eescirocco85/vca/README.md

# vca
Voltage Controlled Amp with loudness for our Record Player
