eescirocco85/vca/vca.kicad_pcb

## KiCad design vca.kicad_pcb (2026-04-27)

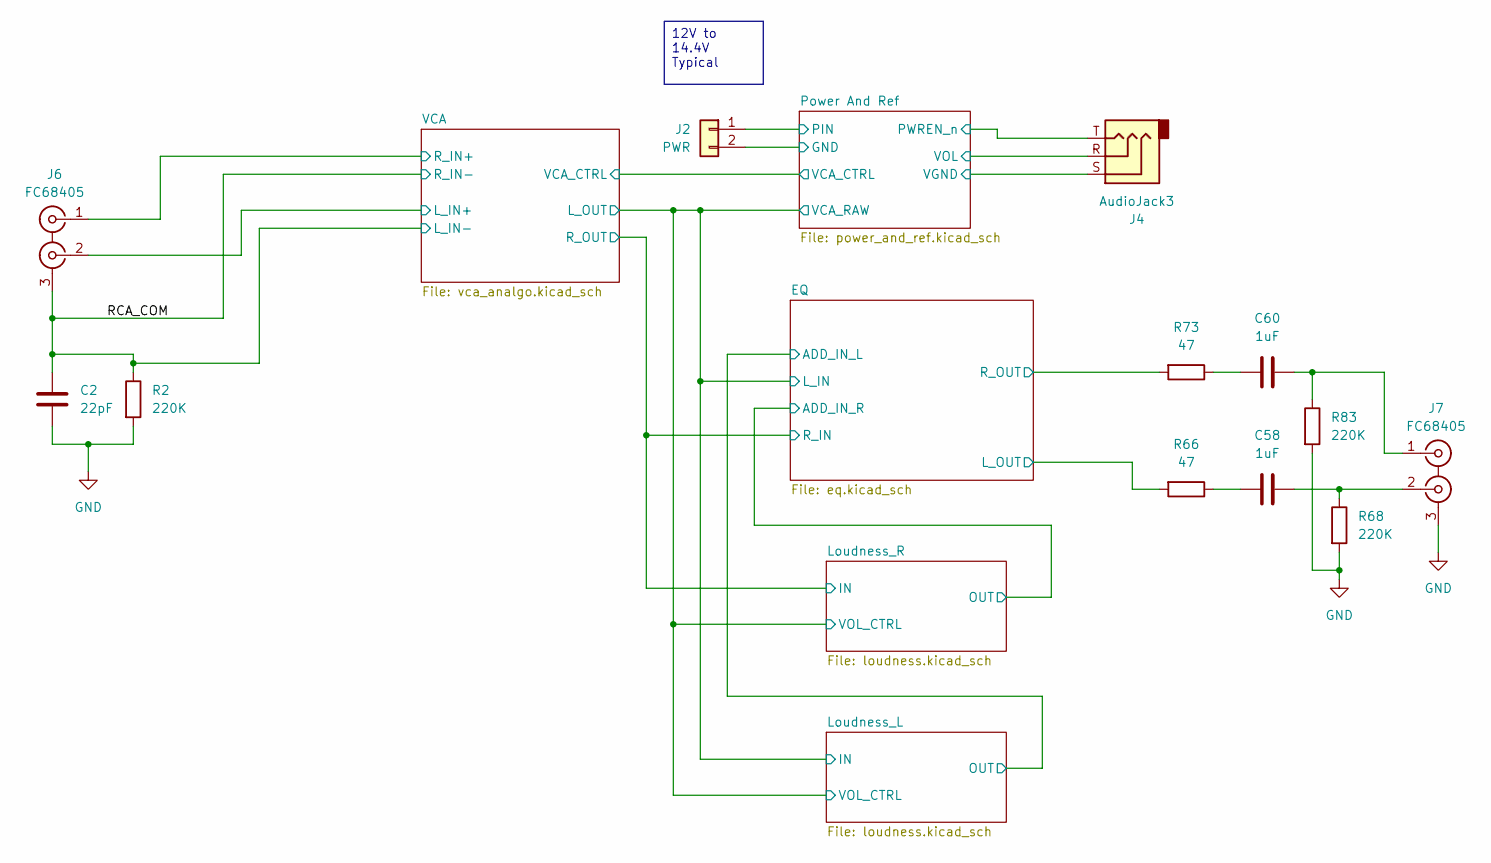
[picture p5: schematic vca.kicad_sch]

Parts:
C2: 22pF; C_0805_2012Metric_Pad1.18x1.45mm_HandSolder
C58, C60: 1uF; C_1210_3225Metric_Pad1.33x2.70mm_HandSolder
J2: PWR; BarrelJack_CUI_PJ-063AH_Horizontal_CircularHoles
J4: AudioJack3; Jack_3.5mm_CUI_SJ1-3533NG_Horizontal_CircularHoles
J6, J7: FC68405; DualVertRca
R2, R68, R83: 220K; R_1206_3216Metric_Pad1.30x1.75mm_HandSolder
R66, R73: 47; R_1206_3216Metric_Pad1.30x1.75mm_HandSolder

Connections:
/EQ/L_OUT: R66.2; also elsewhere on the board
/EQ/R_OUT: R73.2; also elsewhere on the board
/Power And Ref/PIN: J2.1; also elsewhere on the board
/Power And Ref/PWREN_n: J4.T; also elsewhere on the board
/Power And Ref/VGND: J4.S; also elsewhere on the board
/Power And Ref/VOL: J4.R; also elsewhere on the board
/RCA_COM: C2.1, J6.3 (EXT), R2.1; also elsewhere on the board
/VCA/L_IN+: J6.2 (IN2); also elsewhere on the board
/VCA/R_IN+: J6.1 (IN1); also elsewhere on the board
GND: C2.2, J2.2, J7.3 (EXT), R2.2, R68.2, R83.2; also elsewhere on the board
unnamed: C58.1, R66.1
unnamed: C60.1, R73.1
unnamed: C60.2, J7.1 (IN1), R83.1
unnamed: C58.2, J7.2 (IN2), R68.1

Notes on the sheet:
12V to 14.4V Typical

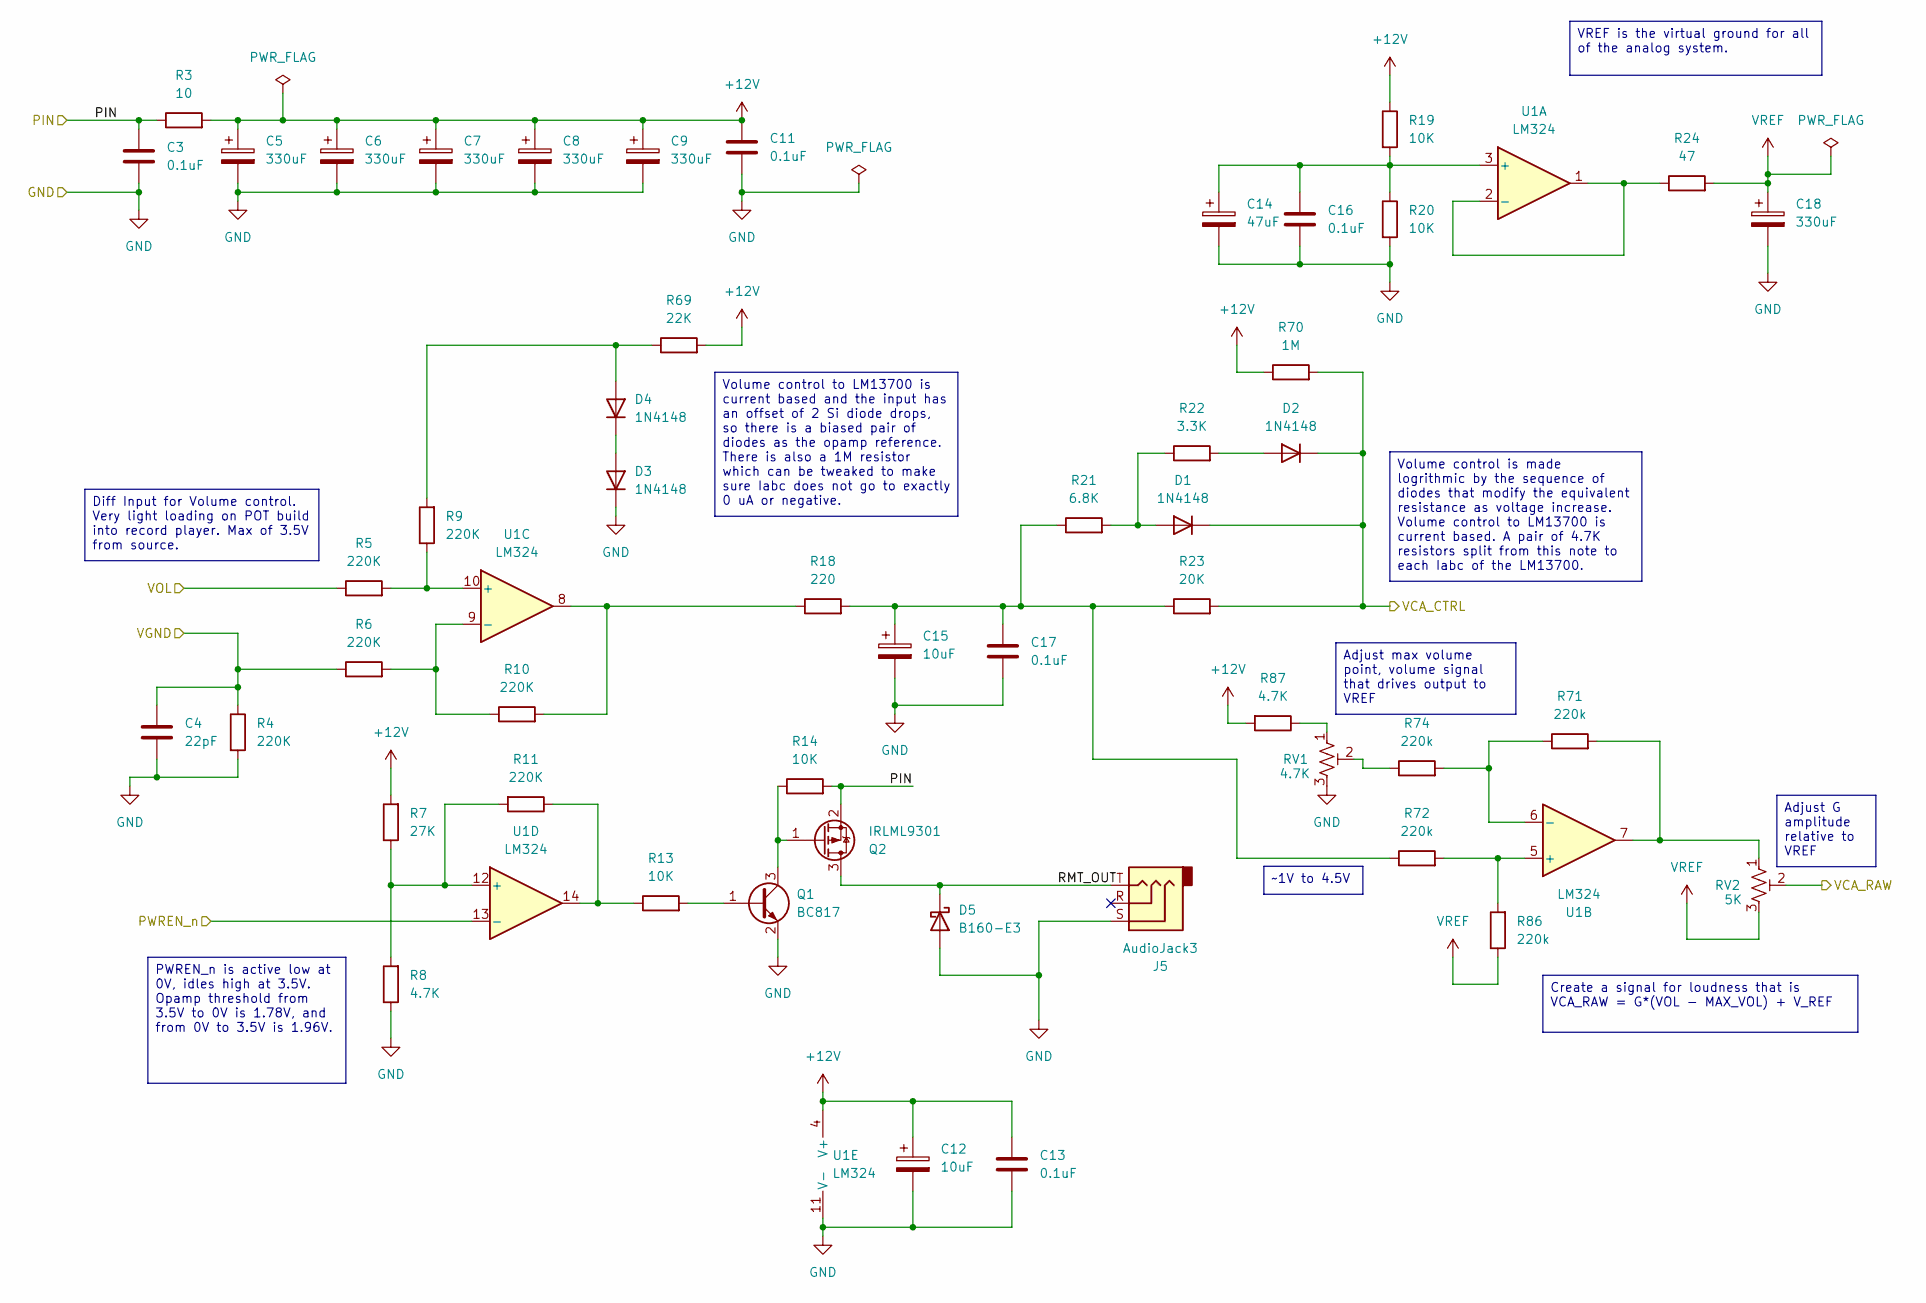
[picture p6: schematic power_and_ref.kicad_sch]

Parts:
C3, C11, C13, C16, C17: 0.1uF; C_0805_2012Metric_Pad1.18x1.45mm_HandSolder
C4: 22pF; C_0805_2012Metric_Pad1.18x1.45mm_HandSolder
C5, C6, C7, C8, C9, C18: 330uF; C_Radial_D10.0mm_H20.0mm_P5.00mm
C12, C15: 10uF; C_Radial_D5.0mm_H11.0mm_P2.00mm
C14: 47uF; C_Radial_D5.0mm_H11.0mm_P2.00mm
D1, D2, D3, D4: 1N4148; D_DO-35_SOD27_P7.62mm_Horizontal
D5: B160-E3; D_SMA
J5: AudioJack3; Jack_3.5mm_CUI_SJ1-3533NG_Horizontal_CircularHoles
Q1: BC817; SOT-23
Q2: IRLML9301; SOT-23
R3: 10; R_1206_3216Metric_Pad1.30x1.75mm_HandSolder
R4, R5, R6, R9, R10, R11: 220K; R_1206_3216Metric_Pad1.30x1.75mm_HandSolder
R7: 27K; R_1206_3216Metric_Pad1.30x1.75mm_HandSolder
R8, R87: 4.7K; R_1206_3216Metric_Pad1.30x1.75mm_HandSolder
R13, R14, R19, R20: 10K; R_1206_3216Metric_Pad1.30x1.75mm_HandSolder
R18: 220; R_1206_3216Metric_Pad1.30x1.75mm_HandSolder
R21: 6.8K; R_1206_3216Metric_Pad1.30x1.75mm_HandSolder
R22: 3.3K; R_1206_3216Metric_Pad1.30x1.75mm_HandSolder
R23: 20K; R_1206_3216Metric_Pad1.30x1.75mm_HandSolder
R24: 47; R_1206_3216Metric_Pad1.30x1.75mm_HandSolder
R69: 22K; R_1206_3216Metric_Pad1.30x1.75mm_HandSolder
R70: 1M; R_1206_3216Metric_Pad1.30x1.75mm_HandSolder
R71, R72, R74, R86: 220k; R_1206_3216Metric_Pad1.30x1.75mm_HandSolder
RV1: 4.7K
RV2: 5K
U1: LM324; SOIC-14_3.9x8.7mm_P1.27mm

Connections:
+12V: C5.1, C6.1, C7.1, C8.1, C9.1, C11.1, C12.1, C13.1, R3.2, R7.2, R19.1, R69.2, R70.1, R87.2, U1.4 (V+); also elsewhere on the board
/Power And Ref/PIN: C3.1, Q2.2 (S), R3.1, R14.2; also elsewhere on the board
/Power And Ref/PWREN_n: U1.13 (-); also elsewhere on the board
/Power And Ref/RMT_OUT: D5.1 (K), J5.T, Q2.3 (D)
/Power And Ref/VCA_CTRL: D1.1 (K), D2.1 (K), R23.2, R70.2; also elsewhere on the board
/Power And Ref/VGND: C4.1, R4.1, R6.1; also elsewhere on the board
/Power And Ref/VOL: R5.1; also elsewhere on the board
GND: C3.2, C4.2, C5.2, C6.2, C7.2, C8.2, C9.2, C11.2, C12.2, C13.2, C14.2, C15.2, C16.2, C17.2, C18.2, D3.1 (K), D5.2 (A), J5.S, Q1.2 (E), R4.2, R8.1, R20.2, RV1.3, U1.11 (V-); also elsewhere on the board
unnamed: C15.1, C17.1, R18.2, R21.1, R23.1, R72.1
unnamed: D1.2 (A), R21.2, R22.1
unnamed: D2.2 (A), R22.2
unnamed: D3.2 (A), D4.1 (K)
unnamed: D4.2 (A), R9.2, R69.1
unnamed: Q1.1 (B), R13.2
unnamed: Q1.3 (C), Q2.1 (G), R14.1
unnamed: R10.2, R18.1, U1.8
unnamed: R11.1, R13.1, U1.14
unnamed: R71.2, RV2.1, U1.7
unnamed: R74.1, RV1.2
unnamed: R87.1, RV1.1
unnamed: C14.1, C16.1, R19.2, R20.1, U1.3 (+)
unnamed: R24.1, U1.1, U1.2 (-)
unnamed: R72.2, R86.2, U1.5 (+)
unnamed: R71.1, R74.2, U1.6 (-)
unnamed: R5.2, R9.1, U1.10 (+)
unnamed: R6.2, R10.1, U1.9 (-)
unnamed: R7.1, R8.2, R11.2, U1.12 (+)
VREF: C18.1, R24.2, R86.1, RV2.3; also elsewhere on the board

Notes on the sheet:
~1V to 4.5V
PWREN_n is active low at 0V, idles high at 3.5V. Opamp threshold from 3.5V to 0V is 1.78V, and from 0V to 3.5V is 1.96V.
Diff Input for Volume control. Very light loading on POT build into record player. Max of 3.5V from source.
Volume control is made logrithmic by the sequence of diodes that modify the equivalent resistance as voltage increase. Volume control to LM13700 is current based. A pair of 4.7K resistors split from this note to each Iabc of the LM13700.
Volume control to LM13700 is current based and the input has an offset of 2 Si diode drops, so there is a biased pair of diodes as the opamp reference. There is also a 1M resistor which can be tweaked to make sure Iabc does not go to exactly 0 uA or negative.
Adjust max volume point, volume signal that drives output to VREF
Adjust G amplitude relative to VREF
VREF is the virtual ground for all of the analog system.
Create a signal for loudness that is VCA_RAW = G*(VOL - MAX_VOL) + V_REF

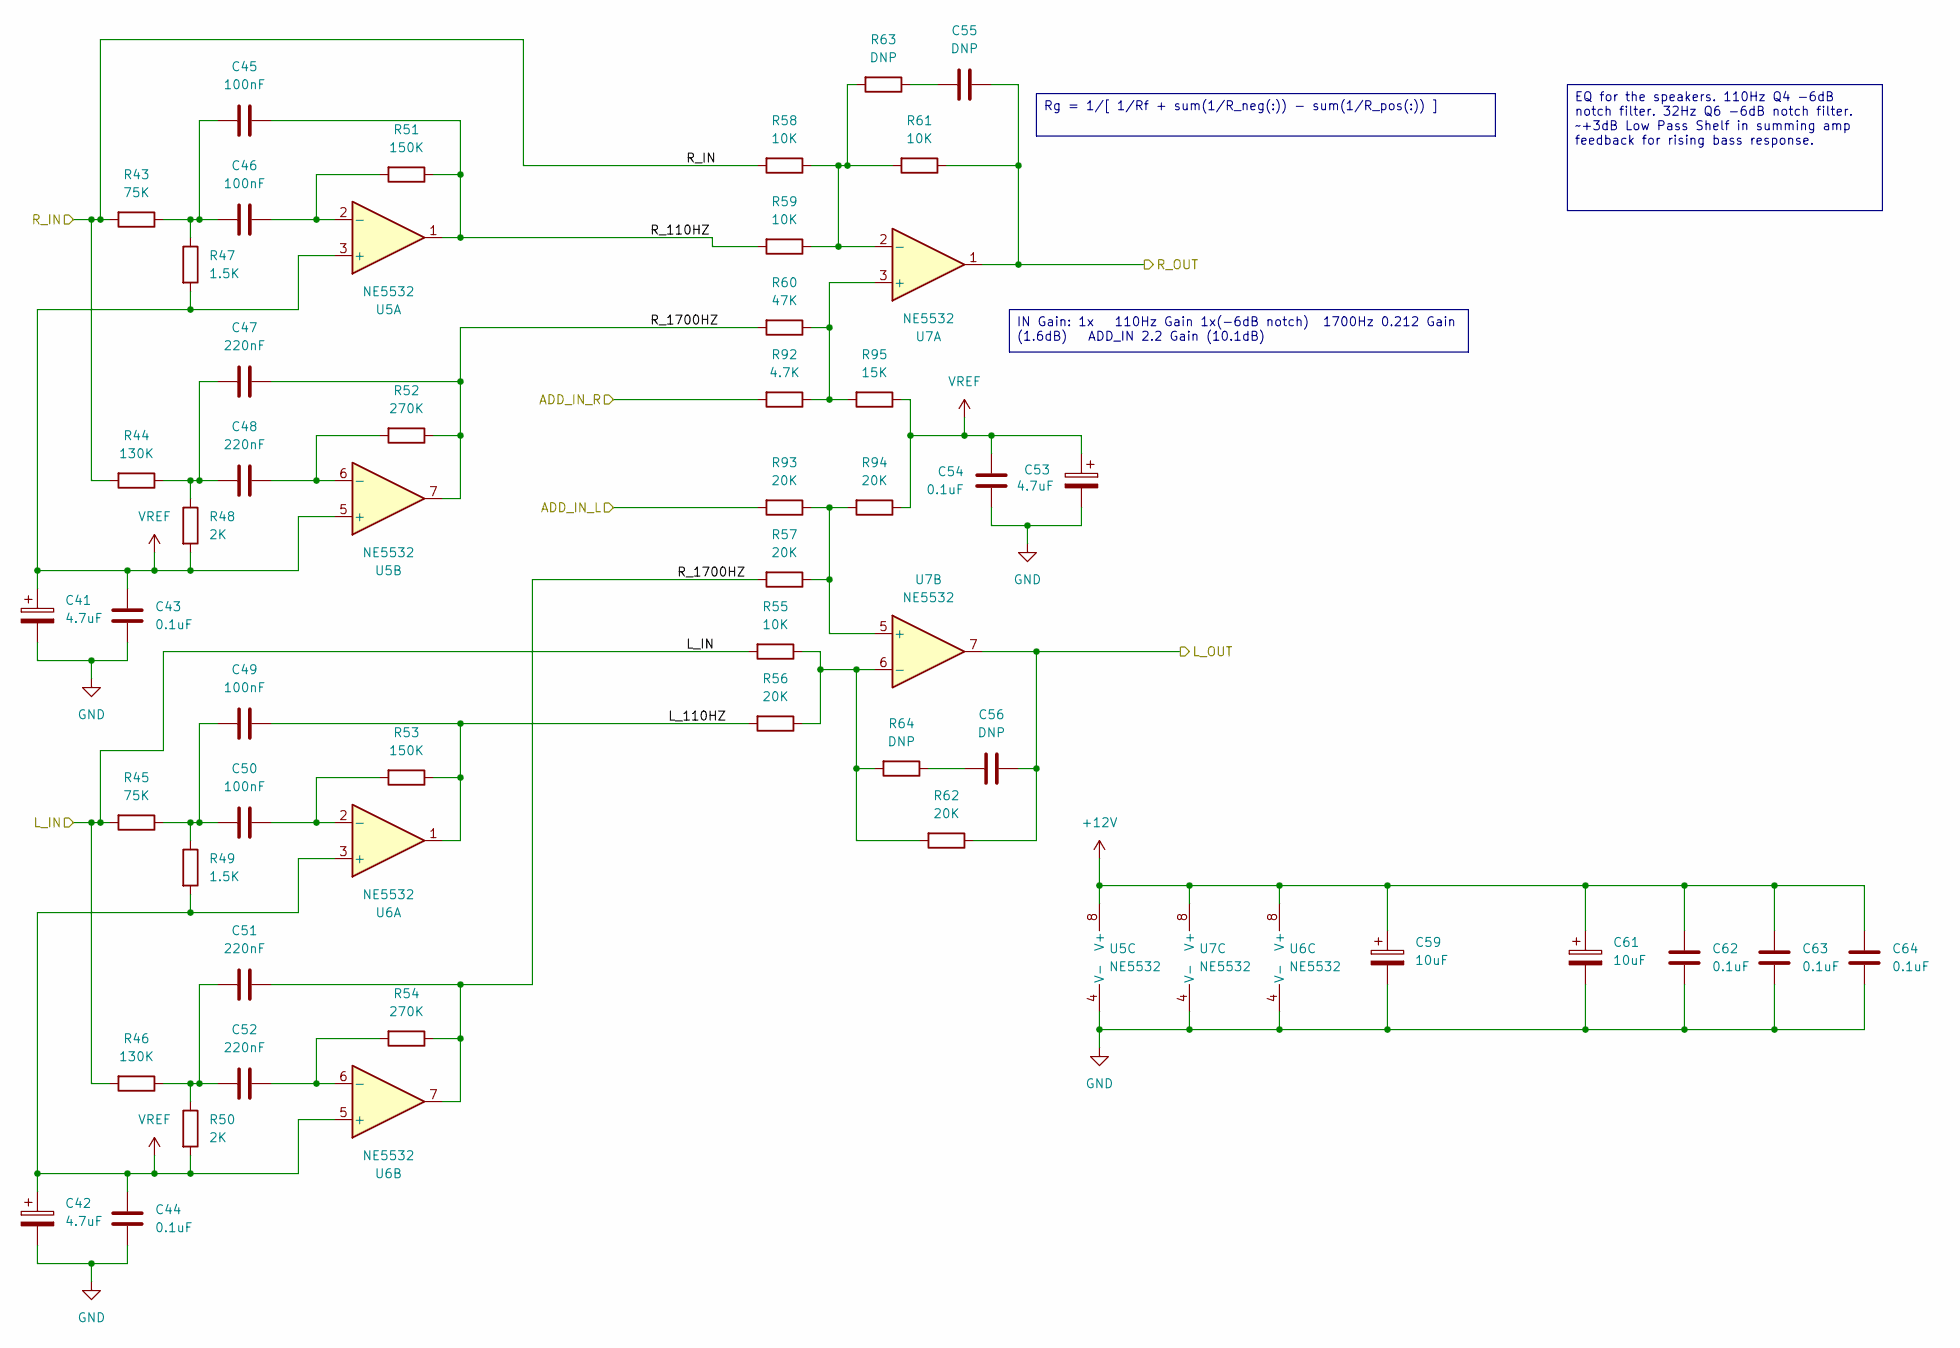
[picture p7: schematic eq.kicad_sch]

Parts:
C41, C42, C53: 4.7uF; C_Radial_D5.0mm_H7.0mm_P2.00mm
C43, C44, C54, C62, C63, C64: 0.1uF; C_0805_2012Metric_Pad1.18x1.45mm_HandSolder
C45, C46, C49, C50: 100nF; C_1812_4532Metric_Pad1.57x3.40mm_HandSolder
C47, C48, C51, C52: 220nF; C_2220_5750Metric_Pad1.97x5.40mm_HandSolder
C55, C56: DNP; C_1812_4532Metric_Pad1.57x3.40mm_HandSolder
C59, C61: 10uF; C_Radial_D5.0mm_H11.0mm_P2.00mm
R43, R45: 75K; R_1206_3216Metric_Pad1.30x1.75mm_HandSolder
R44, R46: 130K; R_1206_3216Metric_Pad1.30x1.75mm_HandSolder
R47, R49: 1.5K; R_1206_3216Metric_Pad1.30x1.75mm_HandSolder
R48, R50: 2K; R_1206_3216Metric_Pad1.30x1.75mm_HandSolder
R51, R53: 150K; R_1206_3216Metric_Pad1.30x1.75mm_HandSolder
R52, R54: 270K; R_1206_3216Metric_Pad1.30x1.75mm_HandSolder
R55, R58, R59, R61: 10K; R_1206_3216Metric_Pad1.30x1.75mm_HandSolder
R56, R57, R62, R93, R94: 20K; R_1206_3216Metric_Pad1.30x1.75mm_HandSolder
R60: 47K; R_1206_3216Metric_Pad1.30x1.75mm_HandSolder
R63, R64: DNP; R_1206_3216Metric_Pad1.30x1.75mm_HandSolder
R92: 4.7K; R_1206_3216Metric_Pad1.30x1.75mm_HandSolder
R95: 15K; R_1206_3216Metric_Pad1.30x1.75mm_HandSolder
U5, U6, U7: NE5532; SOIC-8_3.9x4.9mm_P1.27mm

Connections:
+12V: C59.1, C61.1, C62.1, C63.1, C64.1, U5.8 (V+), U6.8 (V+), U7.8 (V+); also elsewhere on the board
/EQ/ADD_IN_L: R93.2; also elsewhere on the board
/EQ/ADD_IN_R: R92.2; also elsewhere on the board
/EQ/L_110HZ: C49.2, R53.1, R56.2, U6.1
/EQ/L_IN: R45.2, R46.2, R55.2; also elsewhere on the board
/EQ/L_OUT: C56.2, R62.1, U7.7; also elsewhere on the board
/EQ/R_110HZ: C45.2, R51.1, R59.2, U5.1
/EQ/R_1700HZ: C47.2, C51.2, R52.1, R54.1, R57.2, R60.2, U5.7, U6.7
/EQ/R_IN: R43.2, R44.2, R58.2; also elsewhere on the board
/EQ/R_OUT: C55.2, R61.1, U7.1; also elsewhere on the board
GND: C41.2, C42.2, C43.2, C44.2, C53.2, C54.2, C59.2, C61.2, C62.2, C63.2, C64.2, U5.4 (V-), U6.4 (V-), U7.4 (V-); also elsewhere on the board
unnamed: C45.1, C46.1, R43.1, R47.1
unnamed: C47.1, C48.1, R44.1, R48.1
unnamed: C49.1, C50.1, R45.1, R49.1
unnamed: C51.1, C52.1, R46.1, R50.1
unnamed: C55.1, R63.1
unnamed: C56.1, R64.1
unnamed: C46.2, R51.2, U5.2 (-)
unnamed: C48.2, R52.2, U5.6 (-)
unnamed: C50.2, R53.2, U6.2 (-)
unnamed: C52.2, R54.2, U6.6 (-)
unnamed: R60.1, R92.1, R95.2, U7.3 (+)
unnamed: R58.1, R59.1, R61.2, R63.2, U7.2 (-)
unnamed: R57.1, R93.1, R94.2, U7.5 (+)
unnamed: R55.1, R56.1, R62.2, R64.2, U7.6 (-)
VREF: C41.1, C42.1, C43.1, C44.1, C53.1, C54.1, R47.2, R48.2, R49.2, R50.2, R94.1, R95.1, U5.3 (+), U5.5 (+), U6.3 (+), U6.5 (+); also elsewhere on the board

Notes on the sheet:
EQ for the speakers. 110Hz Q4 -6dB notch filter. 32Hz Q6 -6dB notch filter. ~+3dB Low Pass Shelf in summing amp feedback for rising bass response.
Rg = 1/[ 1/Rf + sum(1/R_neg(:)) - sum(1/R_pos(:)) ]
IN Gain: 1x 110Hz Gain 1x(-6dB notch) 1700Hz 0.212 Gain (1.6dB) ADD_IN 2.2 Gain (10.1dB)

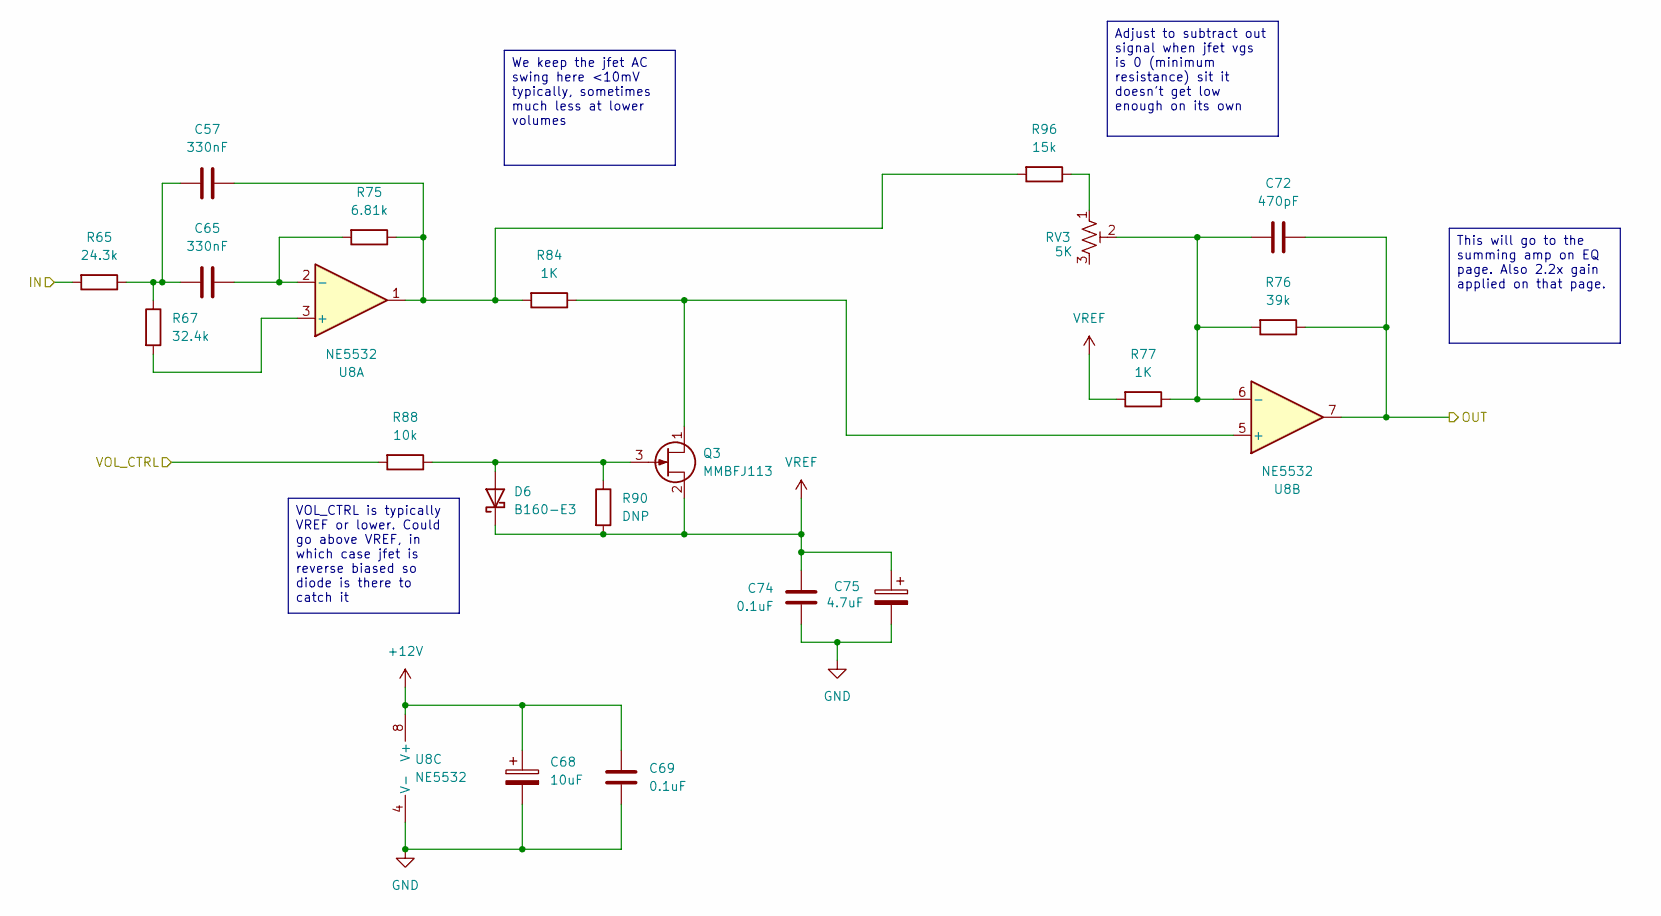
[picture p8: schematic loudness.kicad_sch]

Parts:
C57, C65: 330nF; C_2220_5750Metric_Pad1.97x5.40mm_HandSolder
C68: 10uF; C_Radial_D5.0mm_H11.0mm_P2.00mm
C69, C74: 0.1uF; C_0805_2012Metric_Pad1.18x1.45mm_HandSolder
C72: 470pF; C_0805_2012Metric_Pad1.18x1.45mm_HandSolder
C75: 4.7uF; C_Radial_D5.0mm_H7.0mm_P2.00mm
D6: B160-E3; D_SMA
Q3: MMBFJ113; SOT-23
R65: 24.3k; R_1206_3216Metric_Pad1.30x1.75mm_HandSolder
R67: 32.4k; R_1206_3216Metric_Pad1.30x1.75mm_HandSolder
R75: 6.81k; R_1206_3216Metric_Pad1.30x1.75mm_HandSolder
R76: 39k; R_1206_3216Metric_Pad1.30x1.75mm_HandSolder
R77, R84: 1K; R_1206_3216Metric_Pad1.30x1.75mm_HandSolder
R88: 10k; R_1206_3216Metric_Pad1.30x1.75mm_HandSolder
R90: DNP; R_1206_3216Metric_Pad1.30x1.75mm_HandSolder
R96: 15k; R_1206_3216Metric_Pad1.30x1.75mm_HandSolder
RV3: 5K
U8: NE5532

Connections:
+12V: C68.1, C69.1, U8.8 (V+); also elsewhere on the board
/EQ/ADD_IN_R: C72.2, R76.1; also elsewhere on the board
/EQ/L_IN: R88.2; also elsewhere on the board
/EQ/R_IN: R65.2; also elsewhere on the board
GND: C68.2, C69.2, C74.2, C75.2, U8.4 (V-); also elsewhere on the board
unnamed: C57.1, C65.1, R65.1, R67.1
unnamed: C57.2, R75.1, R84.2
unnamed: D6.2 (A), Q3.3 (G), R88.1, R90.1
unnamed: Q3.1 (D), R84.1
unnamed: R96.1, RV3.1
unnamed: C65.2, R75.2
unnamed: C72.1, R76.2, R77.1
VREF: C74.1, C75.1, D6.1 (K), Q3.2 (S), R77.2, R90.2; also elsewhere on the board

Parts of its further copies:
C70: 10uF; C_Radial_D5.0mm_H11.0mm_P2.00mm
C71, C76: 0.1uF; C_0805_2012Metric_Pad1.18x1.45mm_HandSolder
C73: 470pF; C_0805_2012Metric_Pad1.18x1.45mm_HandSolder
C77: 4.7uF; C_Radial_D5.0mm_H7.0mm_P2.00mm
D7: B160-E3; D_SMA
Q4: MMBFJ113; SOT-23
R81, R85: 1K; R_1206_3216Metric_Pad1.30x1.75mm_HandSolder
R89: 10k; R_1206_3216Metric_Pad1.30x1.75mm_HandSolder
R91: DNP; R_1206_3216Metric_Pad1.30x1.75mm_HandSolder

Connections of its further copies:
+12V: C70.1, C71.1; also elsewhere on the board
/EQ/ADD_IN_L: C73.2; also elsewhere on the board
/EQ/L_IN: R89.2; also elsewhere on the board
GND: C70.2, C71.2, C76.2, C77.2; also elsewhere on the board
unnamed 38: R85.2; also elsewhere on the board
unnamed: D7.2 (A), Q4.3 (G), R89.1, R91.1
unnamed: Q4.1 (D), R85.1
unnamed 87: C73.1, R81.1; also elsewhere on the board
VREF: C76.1, C77.1, D7.1 (K), Q4.2 (S), R81.2, R91.2; also elsewhere on the board

Notes on the sheet:
We keep the jfet AC swing here <10mV typically, sometimes much less at lower volumes
Adjust to subtract out signal when jfet vgs is 0 (minimum resistance) sit it doesn't get low enough on its own
This will go to the summing amp on EQ page. Also 2.2x gain applied on that page.
VOL_CTRL is typically VREF or lower. Could go above VREF, in which case jfet is reverse biased so diode is there to catch it

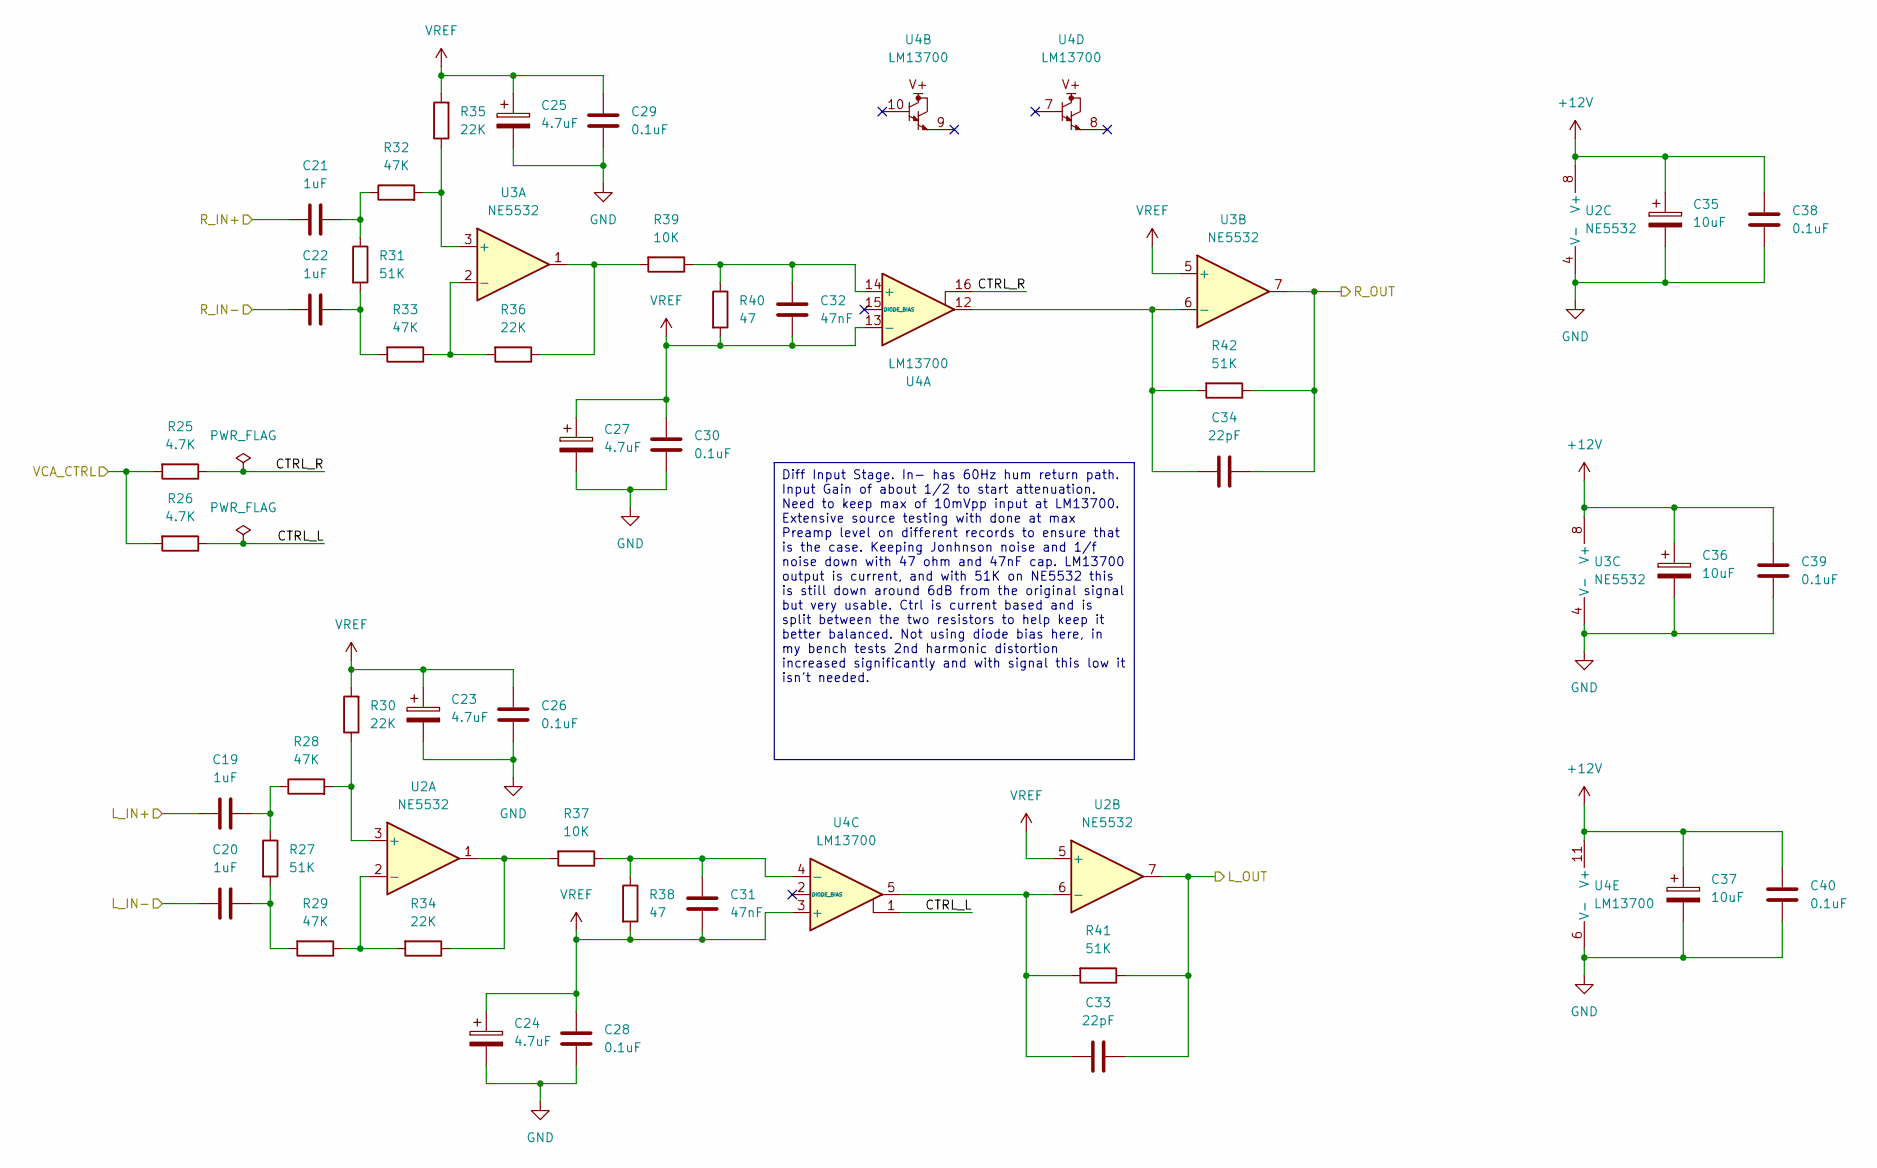
[picture p9: schematic vca_analgo.kicad_sch]

Parts:
C19, C20, C21, C22: 1uF; C_1210_3225Metric_Pad1.33x2.70mm_HandSolder
C23, C24, C25, C27: 4.7uF; C_Radial_D5.0mm_H7.0mm_P2.00mm
C26, C28, C29, C30, C38, C39, C40: 0.1uF; C_0805_2012Metric_Pad1.18x1.45mm_HandSolder
C31, C32: 47nF; C_1812_4532Metric_Pad1.57x3.40mm_HandSolder
C33, C34: 22pF; C_0805_2012Metric_Pad1.18x1.45mm_HandSolder
C35, C36, C37: 10uF; C_Radial_D5.0mm_H11.0mm_P2.00mm
R25, R26: 4.7K; R_1206_3216Metric_Pad1.30x1.75mm_HandSolder
R27, R31, R41, R42: 51K; R_1206_3216Metric_Pad1.30x1.75mm_HandSolder
R28, R29, R32, R33: 47K; R_1206_3216Metric_Pad1.30x1.75mm_HandSolder
R30, R34, R35, R36: 22K; R_1206_3216Metric_Pad1.30x1.75mm_HandSolder
R37, R39: 10K; R_1206_3216Metric_Pad1.30x1.75mm_HandSolder
R38, R40: 47; R_1206_3216Metric_Pad1.30x1.75mm_HandSolder
U2, U3: NE5532; SOIC-8_3.9x4.9mm_P1.27mm
U4: LM13700; SOIC-16_3.9x9.9mm_P1.27mm

Connections:
+12V: C35.1, C36.1, C37.1, C38.1, C39.1, C40.1, U2.8 (V+), U3.8 (V+), U4.11 (V+); also elsewhere on the board
/EQ/L_IN: C33.2, R41.1, U2.7; also elsewhere on the board
/EQ/R_IN: C34.2, R42.1, U3.7; also elsewhere on the board
/Power And Ref/VCA_CTRL: R25.2, R26.2; also elsewhere on the board
/RCA_COM: C20.1, C22.1; also elsewhere on the board
/VCA/CTRL_L: R26.1, U4.1
/VCA/CTRL_R: R25.1, U4.16
/VCA/L_IN+: C19.1; also elsewhere on the board
/VCA/R_IN+: C21.1; also elsewhere on the board
GND: C23.2, C24.2, C25.2, C26.2, C27.2, C28.2, C29.2, C30.2, C35.2, C36.2, C37.2, C38.2, C39.2, C40.2, U2.4 (V-), U3.4 (V-), U4.6 (V-); also elsewhere on the board
unnamed: C19.2, R27.1, R28.1
unnamed: C20.2, R27.2, R29.2
unnamed: C21.2, R31.1, R32.1
unnamed: C22.2, R31.2, R33.2
unnamed: R34.1, R37.2, U2.1
unnamed: R36.1, R39.2, U3.1
unnamed: R28.2, R30.1, U2.3 (+)
unnamed: R29.1, R34.2, U2.2 (-)
unnamed: C33.1, R41.2, U2.6 (-), U4.5
unnamed: R32.2, R35.1, U3.3 (+)
unnamed: R33.1, R36.2, U3.2 (-)
unnamed: C34.1, R42.2, U3.6 (-), U4.12
unnamed: C32.2, R39.1, R40.1, U4.14 (+)
unnamed: C31.2, R37.1, R38.1, U4.4 (-)
VREF: C23.1, C24.1, C25.1, C26.1, C27.1, C28.1, C29.1, C30.1, C31.1, C32.1, R30.2, R35.2, R38.2, R40.2, U2.5 (+), U3.5 (+), U4.3 (+), U4.13 (-); also elsewhere on the board

Notes on the sheet:
Diff Input Stage. In- has 60Hz hum return path. Input Gain of about 1/2 to start attenuation. Need to keep max of 10mVpp input at LM13700. Extensive source testing with done at max Preamp level on different records to ensure that is the case. Keeping Jonhnson noise and 1/f noise down with 47 ohm an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

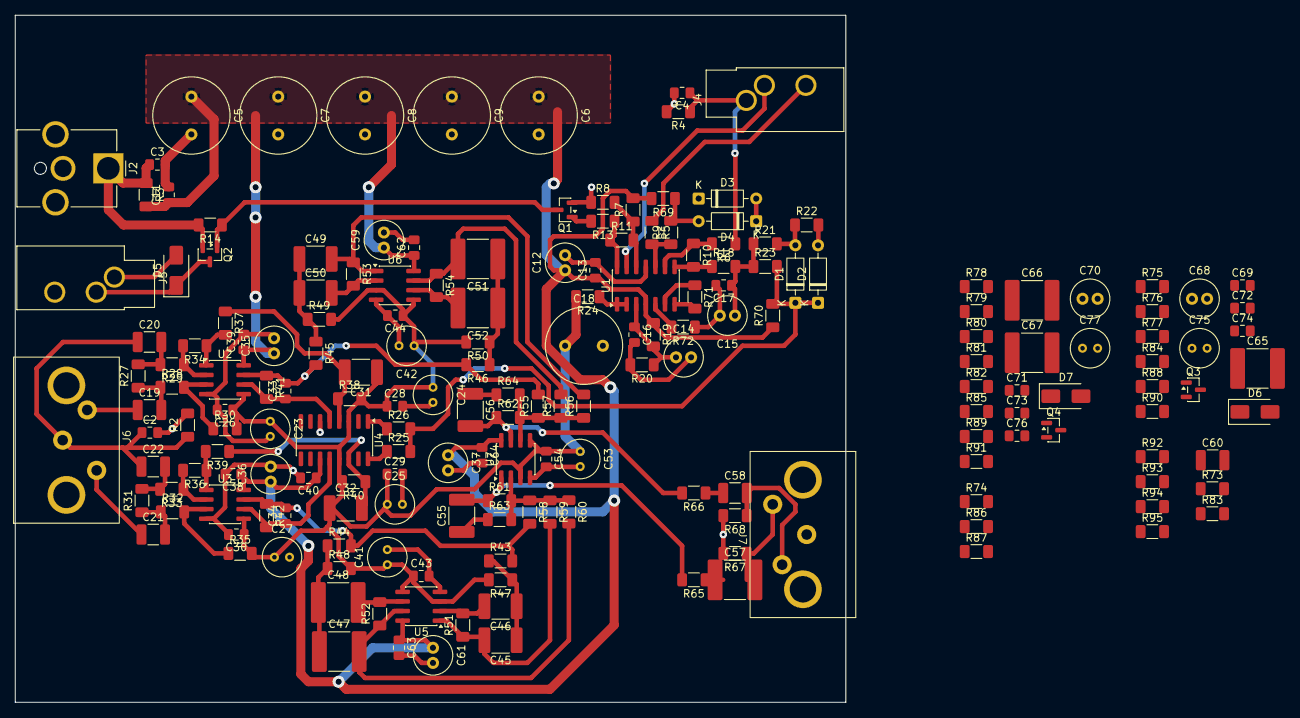
[picture p10: board vca.kicad_pcb from above]

Board: 2 copper layers, 110.0 x 91.0 mm, 188 parts (0 on the bottom side), 84 nets.

Other parts of the board:
C66, C67: 220nF; C_2220_5750Metric_Pad1.97x5.40mm_HandSolder
R78: 75K; R_1206_3216Metric_Pad1.30x1.75mm_HandSolder
R79: 1.5K; R_1206_3216Metric_Pad1.30x1.75mm_HandSolder
R80: 150K; R_1206_3216Metric_Pad1.30x1.75mm_HandSolder
R82: 47K; R_1206_3216Metric_Pad1.30x1.75mm_HandSolder

Their connections:
/EQ/ADD_IN_L: R82.1; also elsewhere on the board
/EQ/L_IN: R78.2; also elsewhere on the board
unnamed: C66.1, C67.1, R78.1, R79.1
unnamed 38: C66.2, R80.1; also elsewhere on the board
unnamed: C67.2, R80.2
unnamed 87: R82.2; also elsewhere on the board
